EnochWong521/digital-audio-synthesizer/hardware/kicad/digital_audio_synthesizer/digital_audio_synthesizer.kicad_pcb

## KiCad design hardware/kicad/digital_audio_synthesizer/digital_audio_synthesizer.kicad_pcb (2026-11-08)

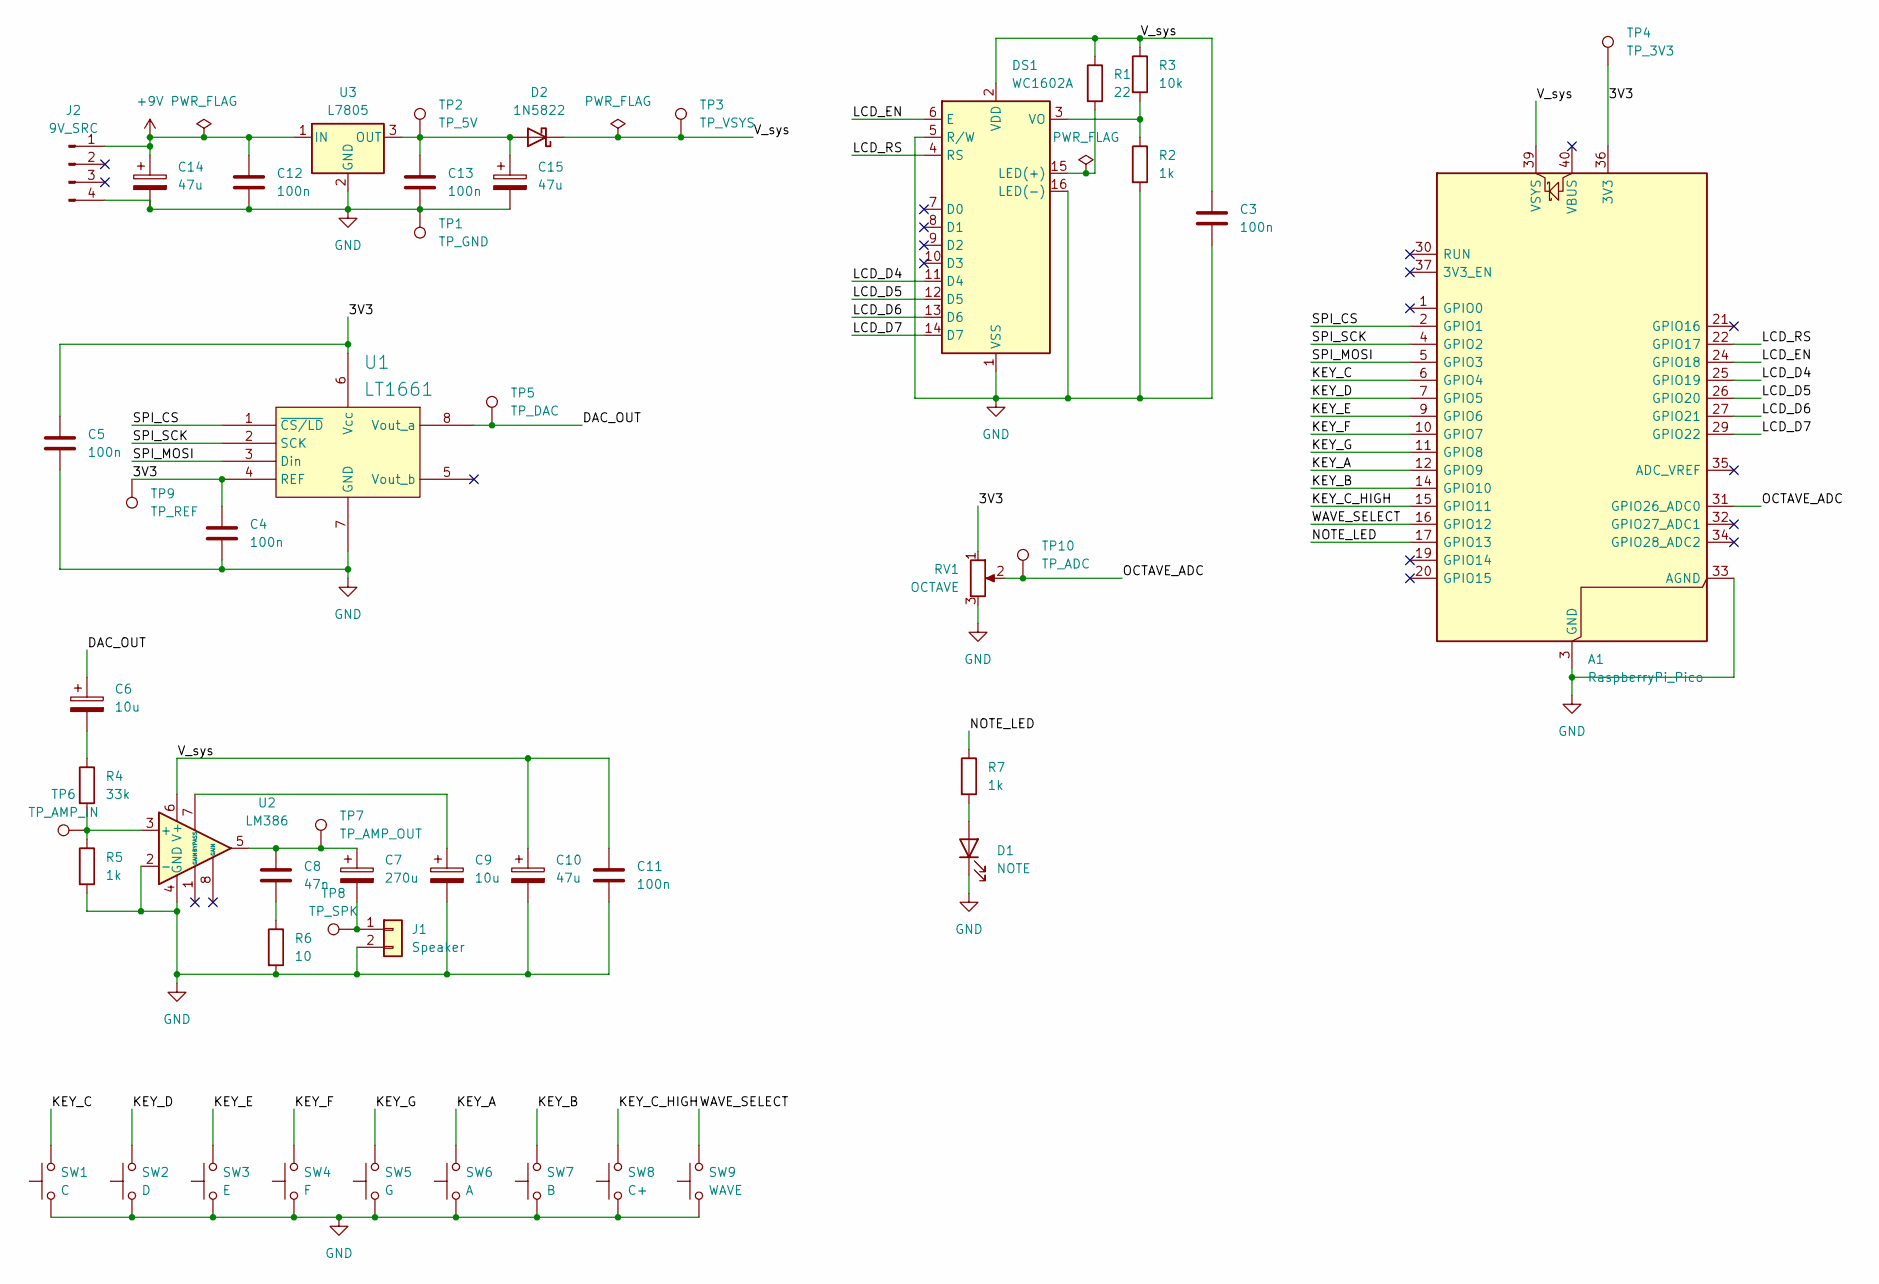
[picture p1: schematic digital_audio_synthesizer.kicad_sch]

Parts:
A1: RaspberryPi_Pico; RaspberryPi_Pico_Common_THT
C3, C4, C5, C11, C12, C13: 100n; C_Disc_D5.0mm_W2.5mm_P5.00mm
C6, C9: 10u; CP_Radial_D5.0mm_P2.50mm
C7: 270u; CP_Radial_D8.0mm_P3.50mm
C8: 47n; C_Disc_D3.8mm_W2.6mm_P2.50mm
C10, C14, C15: 47u; CP_Radial_D5.0mm_P2.50mm
D1: NOTE; LED_D5.0mm
D2: 1N5822; D_DO-201AD_P15.24mm_Horizontal
DS1: WC1602A
J1: Speaker; PinHeader_1x02_P2.54mm_Vertical
J2: 9V_SRC; PinHeader_1x04_P2.54mm_Vertical
R1: 22; R_Axial_DIN0204_L3.6mm_D1.6mm_P7.62mm_Horizontal
R2, R5, R7: 1k; R_Axial_DIN0207_L6.3mm_D2.5mm_P7.62mm_Horizontal
R3: 10k; R_Axial_DIN0207_L6.3mm_D2.5mm_P7.62mm_Horizontal
R4: 33k; R_Axial_DIN0207_L6.3mm_D2.5mm_P7.62mm_Horizontal
R6: 10; R_Axial_DIN0207_L6.3mm_D2.5mm_P7.62mm_Horizontal
RV1: OCTAVE; Potentiometer_Piher_PT-10-V10_Vertical
SW1: C; SW_PUSH_6mm_H4.3mm
SW2: D; SW_PUSH_6mm_H4.3mm
SW3: E; SW_PUSH_6mm_H4.3mm
SW4: F; SW_PUSH_6mm_H4.3mm
SW5: G; SW_PUSH_6mm_H4.3mm
SW6: A; SW_PUSH_6mm_H4.3mm
SW7: B; SW_PUSH_6mm_H4.3mm
SW8: C+; SW_PUSH_6mm_H4.3mm
SW9: WAVE; SW_PUSH_6mm_H4.3mm
TP1: TP_GND; TestPoint_THTPad_D2.0mm_Drill1.0mm
TP2: TP_5V; TestPoint_THTPad_D2.0mm_Drill1.0mm
TP3: TP_VSYS; TestPoint_THTPad_D2.0mm_Drill1.0mm
TP4: TP_3V3; TestPoint_THTPad_D2.0mm_Drill1.0mm
TP5: TP_DAC; TestPoint_THTPad_D2.0mm_Drill1.0mm
TP6: TP_AMP_IN; TestPoint_THTPad_D2.0mm_Drill1.0mm
TP7: TP_AMP_OUT; TestPoint_THTPad_D2.0mm_Drill1.0mm
TP8: TP_SPK; TestPoint_THTPad_D2.0mm_Drill1.0mm
TP9: TP_REF; TestPoint_THTPad_D2.0mm_Drill1.0mm
TP10: TP_ADC; TestPoint_THTPad_D2.0mm_Drill1.0mm
U1: LT1661; DIP-8_W7.62mm
U2: LM386; DIP-8_W7.62mm
U3: L7805; TO-220-3_Vertical

Connections:
+9V: C12.1, C14.1, J2.1, U3.1 (IN)
/3V3: A1.36 (3V3), C4.1, C5.1, RV1.1, TP4.1 (1_1), TP9.1 (1_1), U1.4 (REF), U1.6 (Vcc)
/DAC_OUT: C6.1, TP5.1 (1_1), U1.8 (Vout_a)
/KEY_A: A1.12 (GPIO9), SW6.2
/KEY_B: A1.14 (GPIO10), SW7.2
/KEY_C: A1.6 (GPIO4), SW1.2
/KEY_C_HIGH: A1.15 (GPIO11), SW8.2
/KEY_D: A1.7 (GPIO5), SW2.2
/KEY_E: A1.9 (GPIO6), SW3.2
/KEY_F: A1.10 (GPIO7), SW4.2
/KEY_G: A1.11 (GPIO8), SW5.2
/LCD_D4: A1.25 (GPIO19), DS1.11 (D4)
/LCD_D5: A1.26 (GPIO20), DS1.12 (D5)
/LCD_D6: A1.27 (GPIO21), DS1.13 (D6)
/LCD_D7: A1.29 (GPIO22), DS1.14 (D7)
/LCD_EN: A1.24 (GPIO18), DS1.6 (E)
/LCD_RS: A1.22 (GPIO17), DS1.4 (RS)
/NOTE_LED: A1.17 (GPIO13), R7.1
/OCTAVE_ADC: A1.31 (GPIO26_ADC0), RV1.2, TP10.1 (1_1)
/SPI_CS: A1.2 (GPIO1), U1.1 (~CS/LD)
/SPI_MOSI: A1.5 (GPIO3), U1.3 (Din)
/SPI_SCK: A1.4 (GPIO2), U1.2 (SCK)
/V_sys: A1.39 (VSYS), C3.1, C10.1, C11.1, D2.1 (K), DS1.2 (VDD), R1.1, R3.1, TP3.1 (1_1), U2.6 (V+)
/WAVE_SELECT: A1.16 (GPIO12), SW9.2
GND: A1.3 (GND), A1.8 (GND), A1.13 (GND), A1.18 (GND), A1.23 (GND), A1.28 (GND), A1.33 (AGND), A1.38 (GND), C3.2, C4.2, C5.2, C9.2, C10.2, C11.2, C12.2, C13.2, C14.2, C15.2, D1.1 (K), DS1.1 (VSS), DS1.5 (R/W), DS1.16 (LED(-)), J1.2, J2.4, R2.2, R5.2, R6.2, RV1.3, SW1.1, SW2.1, SW3.1, SW4.1, SW5.1, SW6.1, SW7.1, SW8.1, SW9.1, TP1.1 (1_1), U1.7 (GND), U2.2 (-), U2.4 (GND), U3.2 (GND)
unnamed: C6.2, R4.1
unnamed: C7.1, C8.1, TP7.1 (1_1), U2.5
unnamed: C8.2, R6.1
unnamed: D1.2 (A), R7.2
unnamed: C13.1, C15.1, D2.2 (A), TP2.1 (1_1), U3.3 (OUT)
unnamed: DS1.15 (LED(+)), R1.2
unnamed: DS1.3 (VO), R2.1, R3.2
unnamed: C7.2, J1.1, TP8.1 (1_1)
unnamed: R4.2, R5.1, TP6.1 (1_1), U2.3 (+)
unnamed: C9.1, U2.7 (BYPASS)

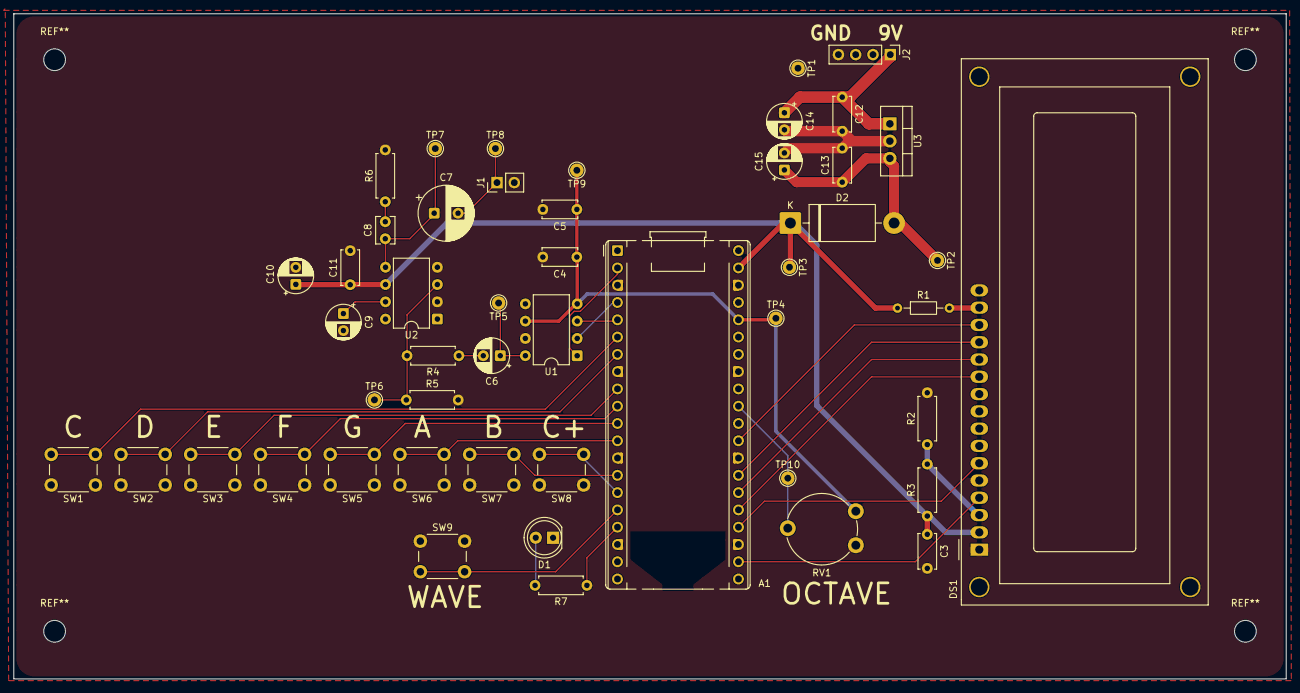
[picture p2: board digital_audio_synthesizer.kicad_pcb from above]

Board: 2 copper layers, 187.0 x 97.8 mm, 49 parts (0 on the bottom side), 35 nets.
