EnochWong521/digital-audio-synthesizer/(commit log)

2026-11-01 Schematic for LCD display
    [digital_audio_synthesizer.kicad_pcb, digital_audio_synthesizer.kicad_sch]
2026-11-01 Stop tracking KiCad local preferences
2026-11-01 LCD schematic corrected
    [digital_audio_synthesizer.kicad_sch]
2026-11-02 ADC for octave tuning working
2026-11-02 Octave ADC schematic done
    [digital_audio_synthesizer.kicad_sch]
2026-11-02 Buttons for notes and waveform select completed. Both schematics and code
    [digital_audio_synthesizer.kicad_sch]
2026-11-06 Optimized SPI firmware
2026-11-06 Updated firmware for LED output. Schematic complete with ERC passed
    [digital_audio_synthesizer.kicad_sch]
2026-11-08 PCB routing complete. TODO: add text for the buttons; ground pour
    [digital_audio_synthesizer.kicad_pcb, digital_audio_synthesizer.kicad_sch]
2026-11-08 PCB layout complete. Board ordered
    [digital_audio_synthesizer-B_Cu.gbr, digital_audio_synthesizer-B_Mask.gbr, digital_audio_synthesizer-Edge_Cuts.gbr, digital_audio_synthesizer-F_Cu.gbr, digital_audio_synthesizer-F_Mask.gbr, digital_audio_synthesizer-F_Silkscreen.gbr, digital_audio_synthesizer-NPTH.drl, digital_audio_synthesizer-PTH.drl]
